irregular257/logistics-robot/Core/Src/main.c

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
/* Includes ------------------------------------------------------------------*/
#include "main.h"
#include "can.h"
#include "tim.h"
#include "usart.h"
#include "gpio.h"

/* USER CODE BEGIN Includes */
#include "motor.h"
#include "mctrl.h"
#include "stm32f4xx_it.h"
#include "roboarm.h"
#include "control.h"
#include "motion.h"
#include "function.h"
#include "duiji.h"
#include "jy61p.h"
#include "state.h"
#include "pid.h"
#include "tjc_usart_hmi.h"
#include "dm_imu.h"
#include "vision_follow.h"
#include "web_control.h"
#include "logistics_task.h"
#include "app_rtos.h"
#include "motor_bus.h"
#include "robot_control.h"
/* USER CODE END Includes */


/* USER CODE BEGIN PV */
extern uint8_t RxData;
extern uint8_t Openmv_Column_RxPacket[2]; //视觉色块数据接收数组
extern uint8_t Openmv_Annular_RxPacket[2]; ////视觉色环数据接收数组
extern uint8_t g_usart_receivedata;
extern uint8_t aRxBuffer;
extern uint8_t San_Data[8]; //扫码数据接收数组
char str[100];
extern int zero, start; //清零，状态机运行
extern uint16_t task1_flag;
extern float set_angle;
int D1, D2, D3, D4;
extern int16_t tasklimit;




//uint8_t tempBuffer=0,RxBuffer1;
/* USER CODE END PV */

void SystemClock_Config(void);
/**
  * @brief  The application entry point.
  * @retval int
  */
int main(void)
{
    /* MCU Configuration--------------------------------------------------------*/
    /* Reset of all peripherals, Initializes the Flash interface and the Systick. */
    HAL_Init();
    /* Configure the system clock */
    SystemClock_Config();
    /* Initialize all configured peripherals */
    MX_GPIO_Init();
    MX_TIM1_Init();
    MX_USART1_UART_Init();
    MX_USART6_UART_Init();
    MX_UART5_Init();
    MX_USART2_UART_Init();
    MX_USART3_UART_Init();
    MX_UART4_Init();
    MX_CAN1_Init();
    /* USER CODE BEGIN 2 */
    motor_init();
    (void)Duoji_SetPresets(GRAB, OPEN, IN, OUT);
    WebControl_Init();
    HAL_UART_Receive_IT(&huart6, &RxData, 1);
    HAL_UART_Receive_IT(&huart5, &g_usart_receivedata, 1);
    HAL_UART_Receive_IT(&huart1, (uint8_t *)&aRxBuffer, 1);
    HAL_TIM_Base_Start_IT(&htim1);
    Serial_JY61P_Zero_Yaw();
    PID_init();
    initRingBuffer();
    /* Create RTOS objects after all HAL delays and hardware initialization.
     * FreeRTOS may mask interrupts while objects are created before startup. */
    MotorBus_Init();
    RobotControl_Init();
    AppRtos_Start();
    /* USER CODE END 2 */
    /* USER CODE BEGIN WHILE */
    while (1) {
        /* The scheduler owns execution after AppRtos_Start. */
    }
    /* USER CODE END WHILE */
}

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
