irregular257/logistics-robot/HARDWARE/OLED/oled.h

#ifndef __OLED_H
#define __OLED_H 


#include "stdlib.h"	
#include "main.h"

//-----------------OLED端口定义---------------- 
#define OLED_SCLK_Clr() HAL_GPIO_WritePin(OLED_SCL_GPIO_Port, OLED_SCL_Pin,GPIO_PIN_RESET)//??SCL???
#define OLED_SCLK_Set() HAL_GPIO_WritePin(OLED_SCL_GPIO_Port, OLED_SCL_Pin,GPIO_PIN_SET)//??SCL???
#define OLED_SDIN_Clr() HAL_GPIO_WritePin(OLED_SDA_GPIO_Port,OLED_SDA_Pin,GPIO_PIN_RESET)//??SDA???
#define OLED_SDIN_Set() HAL_GPIO_WritePin(OLED_SDA_GPIO_Port,OLED_SDA_Pin,GPIO_PIN_SET)//??SDA???


#define OLED_CMD  0	//写命令
#define OLED_DATA 1	//写数据

void OLED_ClearPoint(uint8_t x,uint8_t y);
void OLED_ColorTurn(uint8_t i);
void OLED_DisplayTurn(uint8_t i);
void I2C_Start(void);
void I2C_Stop(void);
void I2C_WaitAck(void);
void Send_Byte(uint8_t dat);
void OLED_WR_Byte(uint8_t dat,uint8_t mode);
void OLED_DisPlay_On(void);
void OLED_DisPlay_Off(void);
void OLED_Refresh(void);
void OLED_Clear(void);
void OLED_DrawPoint(uint8_t x,uint8_t y,uint8_t t);
void OLED_DrawLine(uint8_t x1,uint8_t y1,uint8_t x2,uint8_t y2,uint8_t mode);
void OLED_DrawCircle(uint8_t x,uint8_t y,uint8_t r);
void OLED_ShowChar(uint8_t x,uint8_t y,uint8_t chr,uint8_t size1,uint8_t mode);
void OLED_ShowChar6x8(uint8_t x,uint8_t y,uint8_t chr,uint8_t mode);
void OLED_ShowString(uint8_t x,uint8_t y,uint8_t *chr,uint8_t size1,uint8_t mode);
void OLED_ShowNum(uint8_t x,uint8_t y,uint32_t num,uint8_t len,uint8_t size1,uint8_t mode);
void OLED_ShowChinese(uint8_t x,uint8_t y,uint8_t num,uint8_t size1,uint8_t mode);
void OLED_ScrollDisplay(uint8_t num,uint8_t space,uint8_t mode);
void OLED_ShowPicture(uint8_t x,uint8_t y,uint8_t sizex,uint8_t sizey,uint8_t BMP[],uint8_t mode);
void OLED_Init(void);
extern unsigned char BMP2[];
extern unsigned char BMP1[];

#endif
