irregular257/logistics-robot/Core/Src/can.c

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
/* Includes ------------------------------------------------------------------*/
#include "can.h"

/* USER CODE BEGIN 0 */
#include "dm_imu.h"
/* USER CODE END 0 */

CAN_HandleTypeDef hcan1;

/* CAN1 init function */
void MX_CAN1_Init(void)
{

  hcan1.Instance = CAN1;
  hcan1.Init.Prescaler = 6;
  hcan1.Init.Mode = CAN_MODE_NORMAL;
  hcan1.Init.SyncJumpWidth = CAN_SJW_2TQ;
  hcan1.Init.TimeSeg1 = CAN_BS1_5TQ;
  hcan1.Init.TimeSeg2 = CAN_BS2_1TQ;
  hcan1.Init.TimeTriggeredMode = DISABLE;
  hcan1.Init.AutoBusOff = DISABLE;
  hcan1.Init.AutoWakeUp = ENABLE;
  hcan1.Init.AutoRetransmission = ENABLE;
  hcan1.Init.ReceiveFifoLocked = DISABLE;
  hcan1.Init.TransmitFifoPriority = DISABLE;
  if (HAL_CAN_Init(&hcan1) != HAL_OK)
  {
    Error_Handler();
  }
}

void HAL_CAN_MspInit(CAN_HandleTypeDef* canHandle)
{

  GPIO_InitTypeDef GPIO_InitStruct = {0};
  if(canHandle->Instance==CAN1)
  {
    /* CAN1 clock enable */
    __HAL_RCC_CAN1_CLK_ENABLE();

    __HAL_RCC_GPIOB_CLK_ENABLE();
    /**CAN1 GPIO Configuration
    PB8     ------> CAN1_RX
    PB9     ------> CAN1_TX
    */
    GPIO_InitStruct.Pin = GPIO_PIN_8|GPIO_PIN_9;
    GPIO_InitStruct.Mode = GPIO_MODE_AF_PP;
    GPIO_InitStruct.Pull = GPIO_NOPULL;
    GPIO_InitStruct.Speed = GPIO_SPEED_FREQ_VERY_HIGH;
    GPIO_InitStruct.Alternate = GPIO_AF9_CAN1;
    HAL_GPIO_Init(GPIOB, &GPIO_InitStruct);

    /* CAN1 interrupt Init */
    HAL_NVIC_SetPriority(CAN1_RX0_IRQn, 0, 0);
    HAL_NVIC_EnableIRQ(CAN1_RX0_IRQn);
    HAL_NVIC_SetPriority(CAN1_RX1_IRQn, 0, 0);
    HAL_NVIC_EnableIRQ(CAN1_RX1_IRQn);
  }
}

void HAL_CAN_MspDeInit(CAN_HandleTypeDef* canHandle)
{

  if(canHandle->Instance==CAN1)
  {
    /* Peripheral clock disable */
    __HAL_RCC_CAN1_CLK_DISABLE();

    /**CAN1 GPIO Configuration
    PB8     ------> CAN1_RX
    PB9     ------> CAN1_TX
    */
    HAL_GPIO_DeInit(GPIOB, GPIO_PIN_8|GPIO_PIN_9);

    /* CAN1 interrupt Deinit */
    HAL_NVIC_DisableIRQ(CAN1_RX0_IRQn);
    HAL_NVIC_DisableIRQ(CAN1_RX1_IRQn);
  }
}

/* USER CODE BEGIN 1 */
void CAN_FilterInit()
{
	CAN_FilterTypeDef filter;
	
	filter.FilterActivation=ENABLE;
	filter.FilterBank=0;
	filter.FilterFIFOAssignment=CAN_FilterFIFO0;
	filter.FilterIdHigh=0x0000;
	filter.FilterIdLow=0x0000;
	filter.FilterMaskIdHigh=0x0000;
	filter.FilterMaskIdLow=0x0000;
	filter.FilterMode=CAN_FILTERMODE_IDMASK;
	filter.FilterScale=CAN_FILTERSCALE_32BIT;
	
	filter.SlaveStartFilterBank=14;
	
	HAL_CAN_ConfigFilter(&hcan1,&filter);
	
}

void HAL_CAN_RxFifo0MsgPendingCallback(CAN_HandleTypeDef *hcan)
{
	CAN_RxHeaderTypeDef rx_header;
	uint8_t pdata[8];
	if(hcan->Instance==CAN1)
	{
		HAL_CAN_GetRxMessage(hcan,CAN_RX_FIFO0,&rx_header,pdata);
		
		if(rx_header.StdId==0x11)
			IMU_UpdateData(pdata);
	}
	
	if(hcan->Instance==CAN2)
	{
		HAL_CAN_GetRxMessage(hcan,CAN_RX_FIFO0,&rx_header,pdata);
		
		if(rx_header.StdId==0x11)
			IMU_UpdateData(pdata);
	}
}
/* USER CODE END 1 */
