irregular257/logistics-robot/Core/Inc/function.h

#ifndef __FUNCTION_H__
#define __FUNCTION_H__
#include "main.h"

void jiaqu4(int i);
void fangzhi7(int i);
void jiaozhun5(uint16_t Targetx1,uint16_t Targety1);
void jiaqu2(int i);
void fangzhi(int i);
void jiaozhun2(uint16_t Targetx2,uint16_t Targety2);



#endif
