irregular257/logistics-robot/tests/servo_review/servo_pwm.cpp

/* Run the production servo driver against HAL's per-channel start semantics. */
#include <assert.h>
#include <stdio.h>
#include <string.h>
extern "C" {
#include "../../Hardware/duoji/duiji.h"
}
static TIM_TypeDef timer_registers;
TIM_HandleTypeDef htim1;
static unsigned starts;
static bool start_fails;
HAL_TIM_ChannelStateTypeDef HAL_TIM_GetChannelState(const TIM_HandleTypeDef *timer, uint32_t channel)
{
    return timer->ChannelState[channel / 4U];
}
HAL_StatusTypeDef HAL_TIM_PWM_Start(TIM_HandleTypeDef *timer, uint32_t channel)
{
    ++starts;
    if (start_fails || timer->ChannelState[channel / 4U] != HAL_TIM_CHANNEL_STATE_READY)
        return HAL_ERROR;
    timer->ChannelState[channel / 4U] = HAL_TIM_CHANNEL_STATE_BUSY;
    timer->Instance->CCER |= 1U << channel;
    timer->Instance->BDTR |= TIM_BDTR_MOE;
    timer->Instance->CR1 |= TIM_CR1_CEN;
    return HAL_OK;
}
static void reset(void)
{
    memset(&timer_registers, 0, sizeof(timer_registers));
    memset(&htim1, 0, sizeof(htim1));
    htim1.Instance = &timer_registers;
    htim1.State = 2U; /* Base_Start_IT has already made the base timer BUSY. */
    for (unsigned i = 0; i < 3; ++i) htim1.ChannelState[i] = HAL_TIM_CHANNEL_STATE_READY;
    starts = 0;
    start_fails = false;
}
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
