irregular257/logistics-robot/(commit log)

2026-11-05 Initial import of logistics robot with ordered material tasks
2026-11-07 Document ESP32-S3 N16R8 setup and verified build
2026-11-09 Migrate STM32 to FreeRTOS and add ESP-NOW turntable integration
